devanshimaleri-hub/WRO2026_TeamAstra/other/20260812_190928.jpg

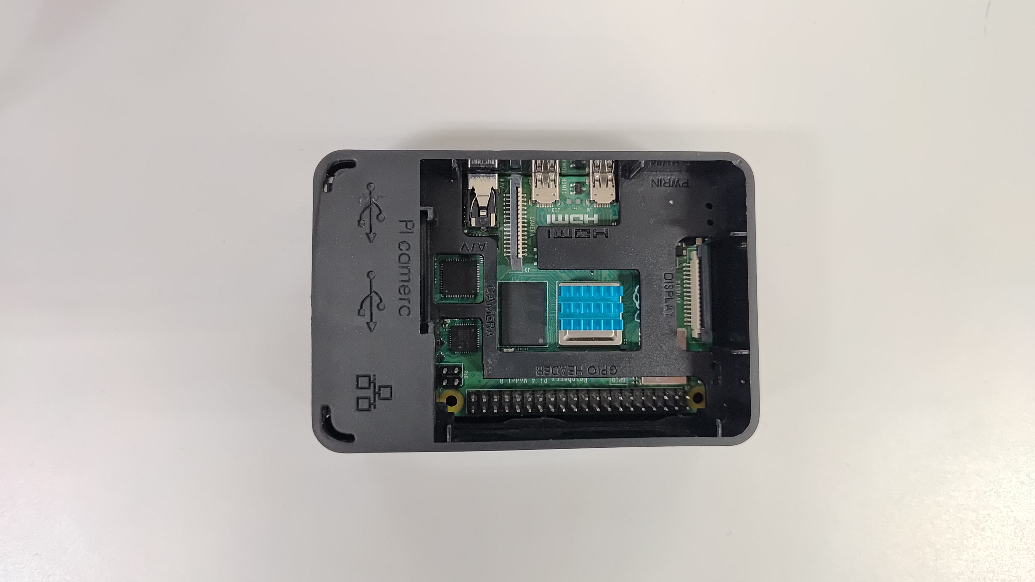
other/20260812_190928.jpg
