devanshimaleri-hub/WRO2026_TeamAstra/other/ackermann-diag.png

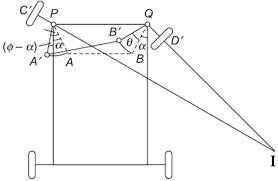
other/ackermann-diag.png
