devanshimaleri-hub/WRO2026_TeamAstra/other/ackermann-steering-linkage.jpg

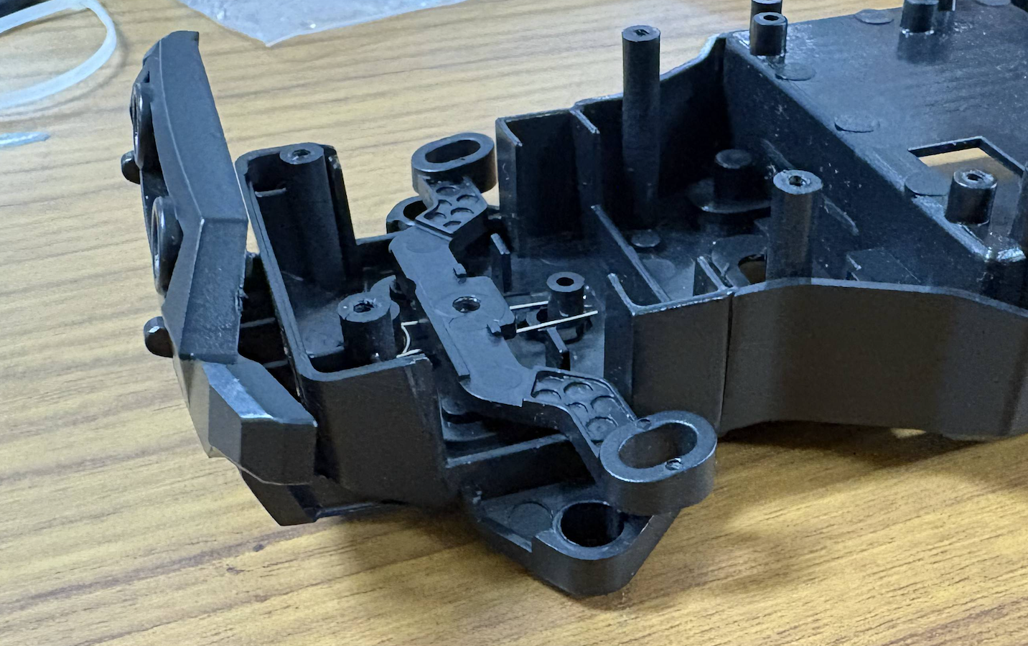
other/ackermann-steering-linkage.jpg
