devanshimaleri-hub/WRO2026_TeamAstra/other/AI cam connections.jpeg

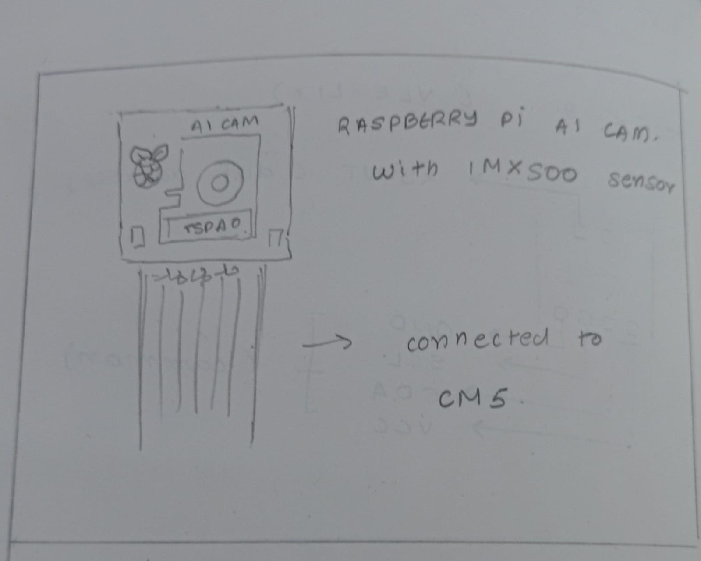
other/AI cam connections.jpeg
