devanshimaleri-hub/WRO2026_TeamAstra/other/baseplate-layout.jpg

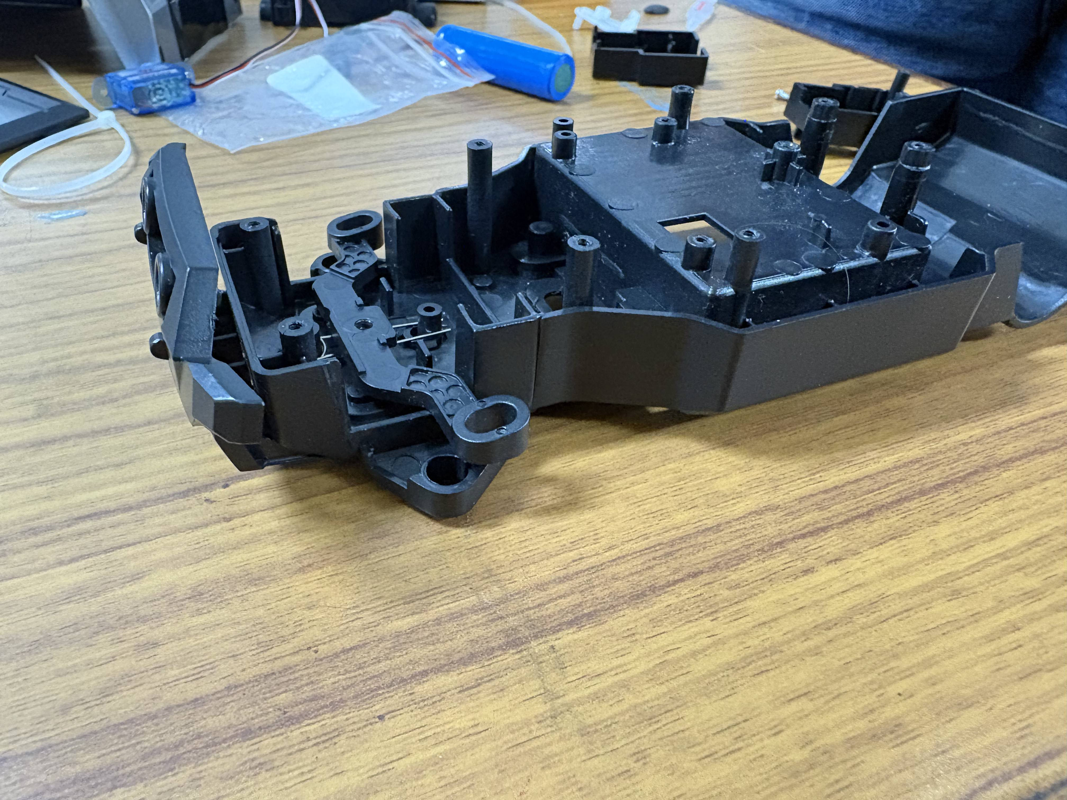
other/baseplate-layout.jpg
