devanshimaleri-hub/WRO2026_TeamAstra/other/Camera connector.jpeg

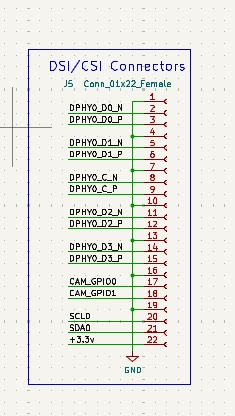
other/Camera connector.jpeg
