devanshimaleri-hub/WRO2026_TeamAstra/other/camera.jpg

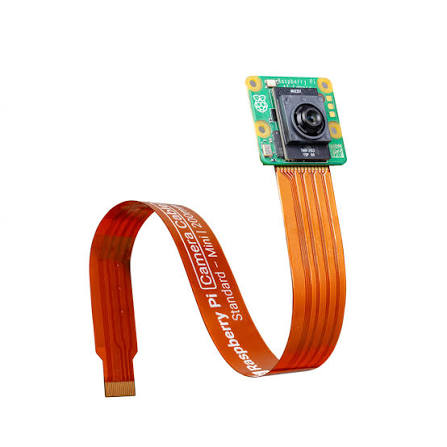
other/camera.jpg
