devanshimaleri-hub/WRO2026_TeamAstra/other/chassis-overview-2.jpg

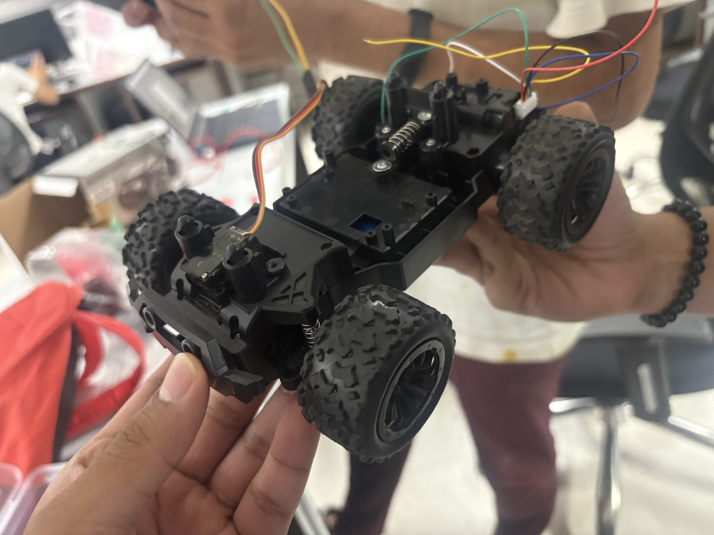
other/chassis-overview-2.jpg
