devanshimaleri-hub/WRO2026_TeamAstra/other/chassis-overview.jpg

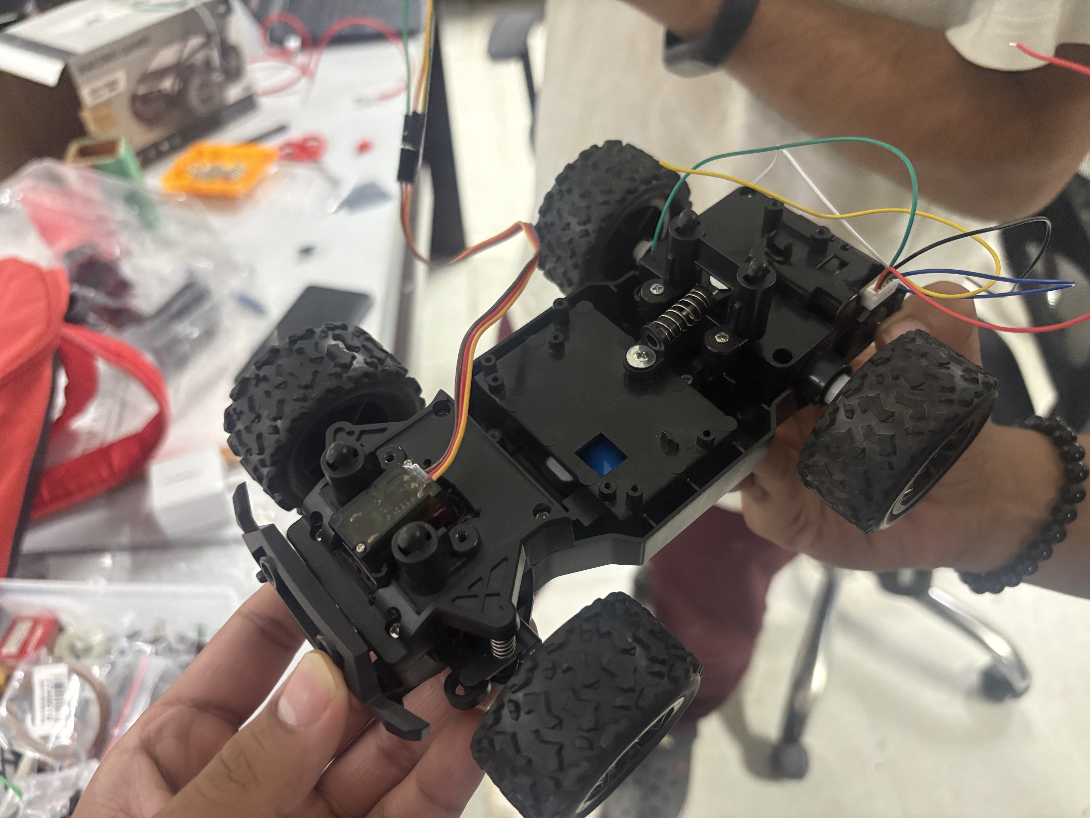
other/chassis-overview.jpg
