devanshimaleri-hub/WRO2026_TeamAstra/other/CM5 connector 1.jpeg

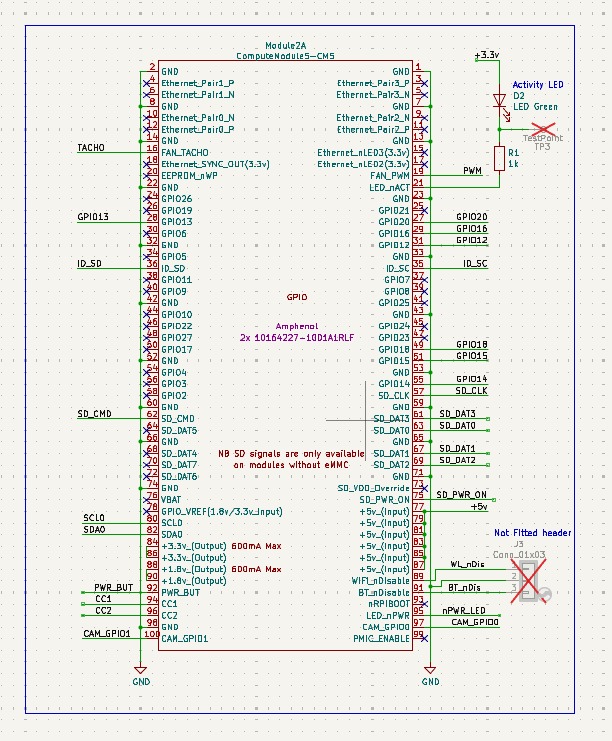
other/CM5 connector 1.jpeg
