devanshimaleri-hub/WRO2026_TeamAstra/other/Current limit switch.jpeg

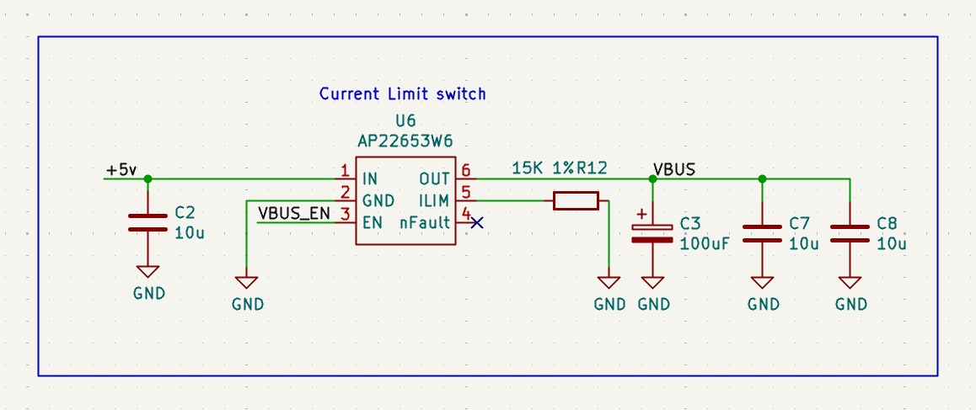
other/Current limit switch.jpeg
