devanshimaleri-hub/WRO2026_TeamAstra/other/differential-drive.jpeg

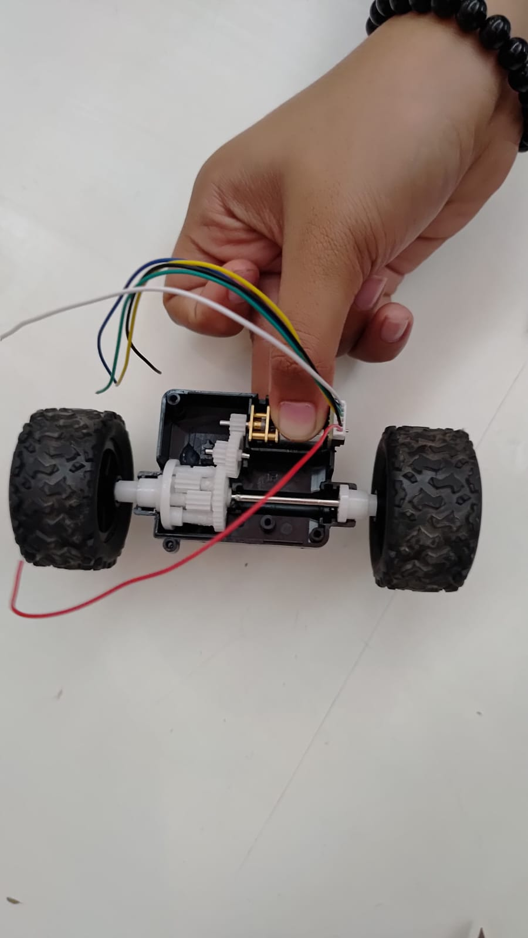
other/differential-drive.jpeg
