devanshimaleri-hub/WRO2026_TeamAstra/other/DRV8833.jpeg

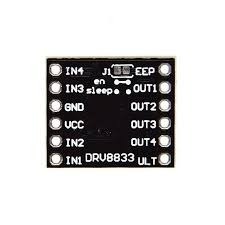
other/DRV8833.jpeg
