devanshimaleri-hub/WRO2026_TeamAstra/other/Fan connector.jpeg

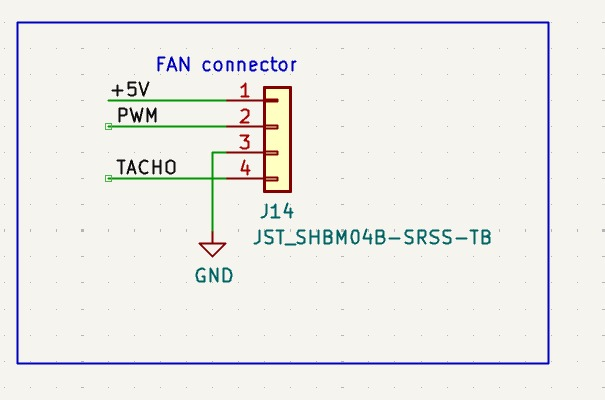
other/Fan connector.jpeg
