devanshimaleri-hub/WRO2026_TeamAstra/other/IMU connections.jpeg

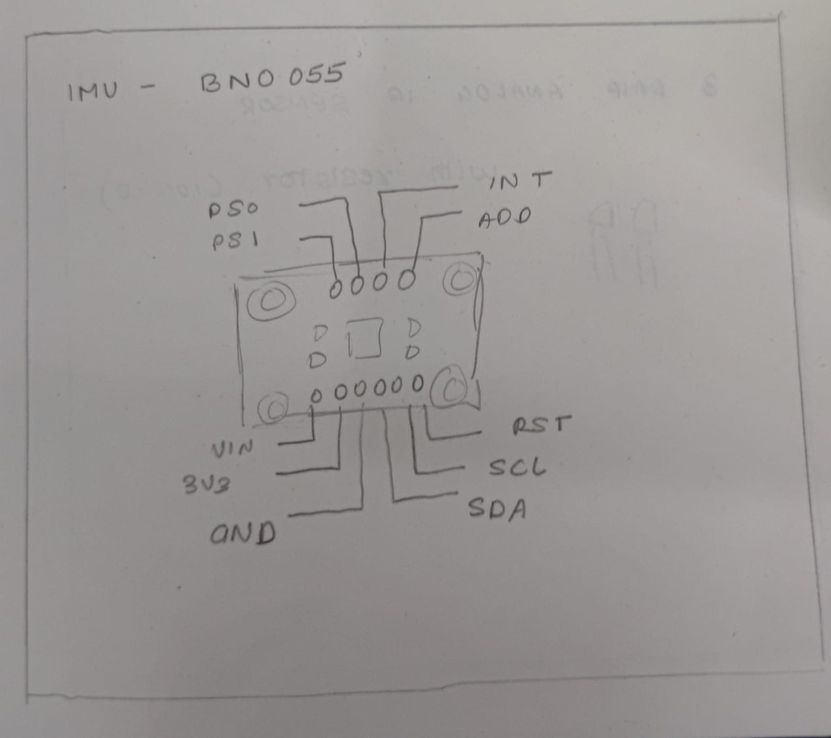
other/IMU connections.jpeg
