devanshimaleri-hub/WRO2026_TeamAstra/other/ir.png

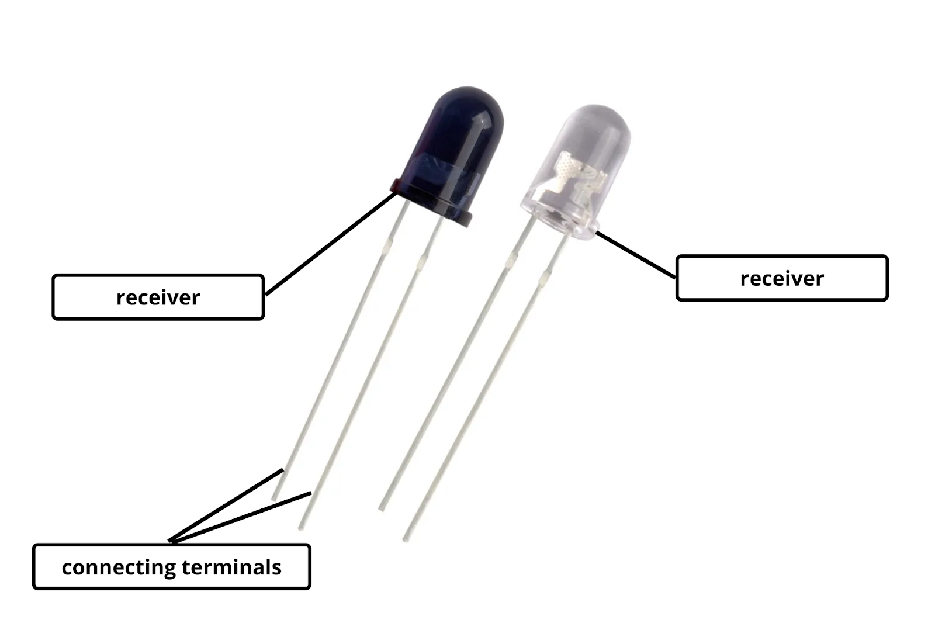
other/ir.png
