devanshimaleri-hub/WRO2026_TeamAstra/other/iteration-1.jpg

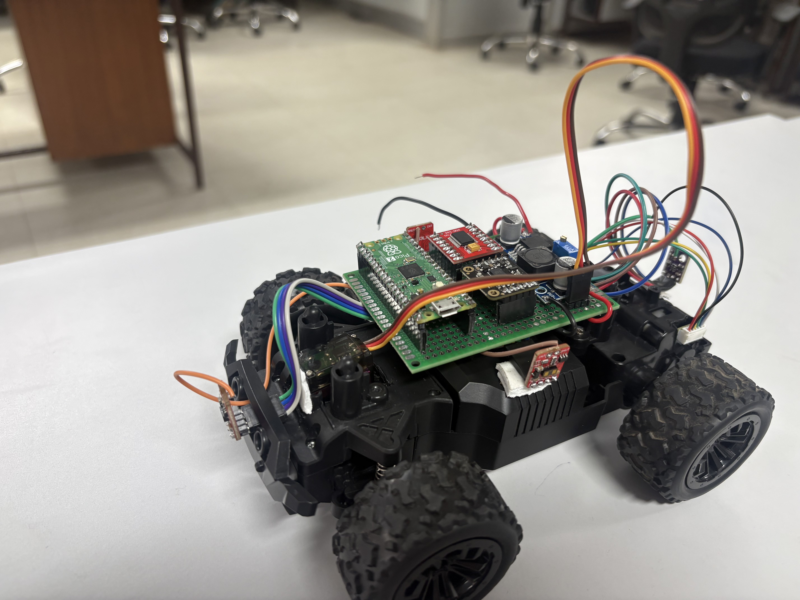
other/iteration-1.jpg
