devanshimaleri-hub/WRO2026_TeamAstra/other/Micro Servo.jpeg

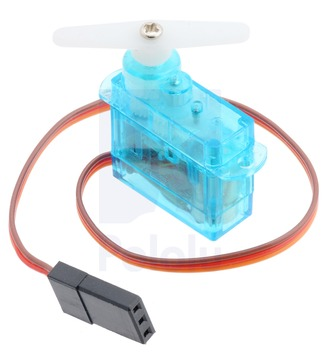
other/Micro Servo.jpeg
