devanshimaleri-hub/WRO2026_TeamAstra/other/SD card.jpeg

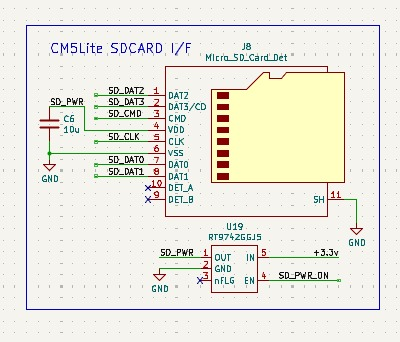
other/SD card.jpeg
