devanshimaleri-hub/WRO2026_TeamAstra/other/servo-mount-for-steering.jpg

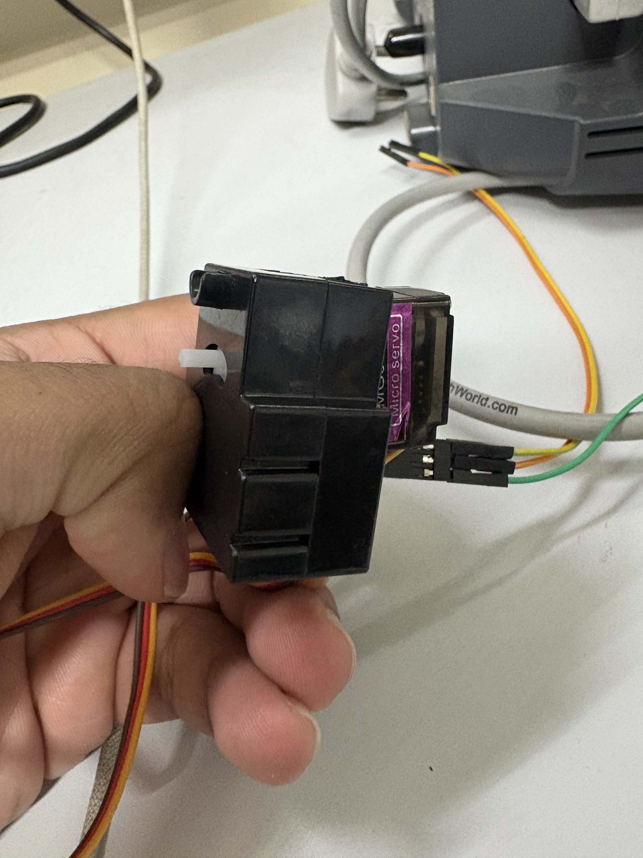
other/servo-mount-for-steering.jpg
