devanshimaleri-hub/WRO2026_TeamAstra/other/Tof connections.jpeg

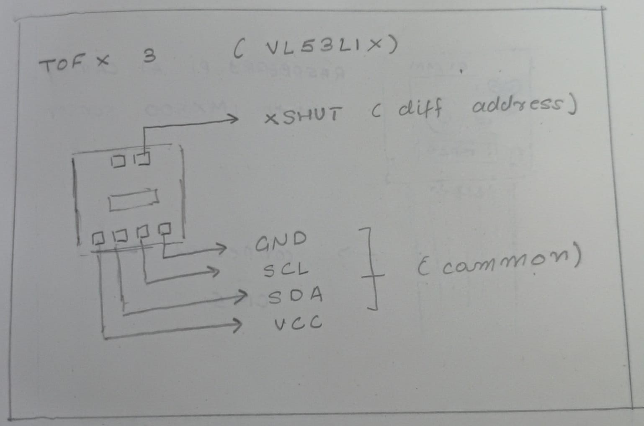
other/Tof connections.jpeg
