devanshimaleri-hub/WRO2026_TeamAstra/other/USB A connector.jpeg

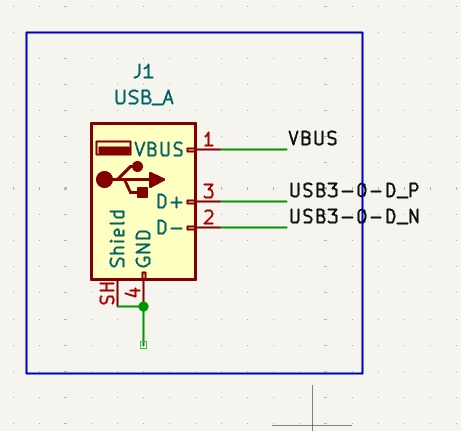
other/USB A connector.jpeg
