devanshimaleri-hub/WRO2026_TeamAstra/other/USB C connector.jpeg

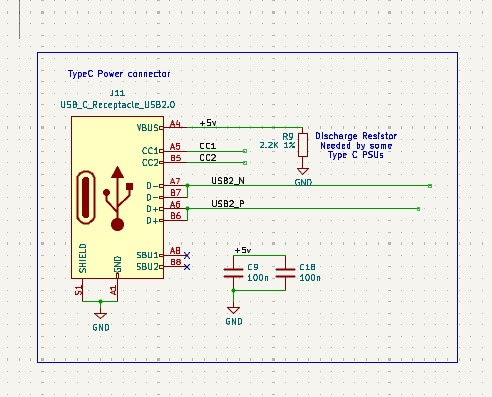
other/USB C connector.jpeg
