devanshimaleri-hub/WRO2026_TeamAstra/other/vl53l1x.jpg

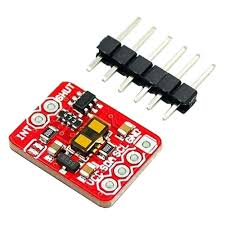
other/vl53l1x.jpg
