devanshimaleri-hub/WRO2026_TeamAstra/other/wheel-config.jpg

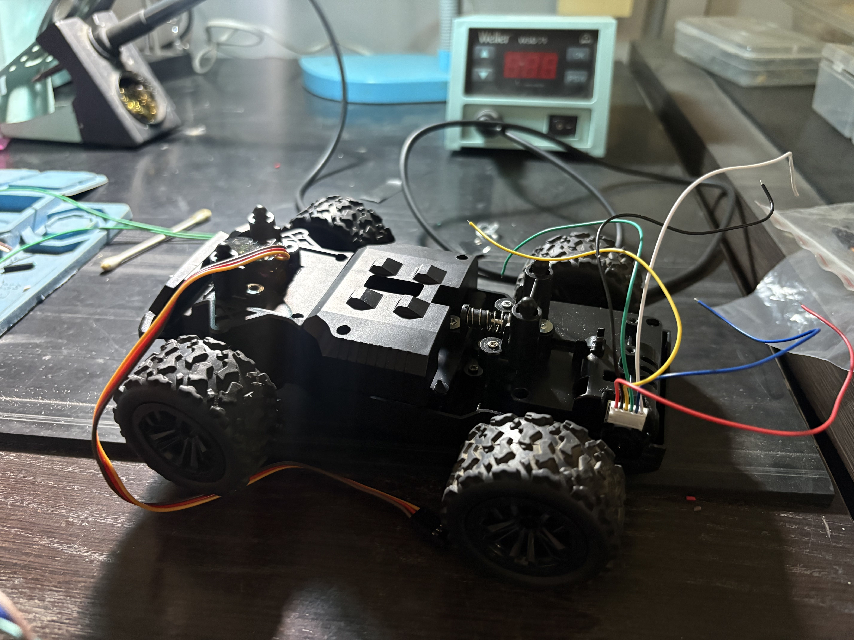
other/wheel-config.jpg
