devanshimaleri-hub/WRO2026_TeamAstra/other/all_wiring.jpg

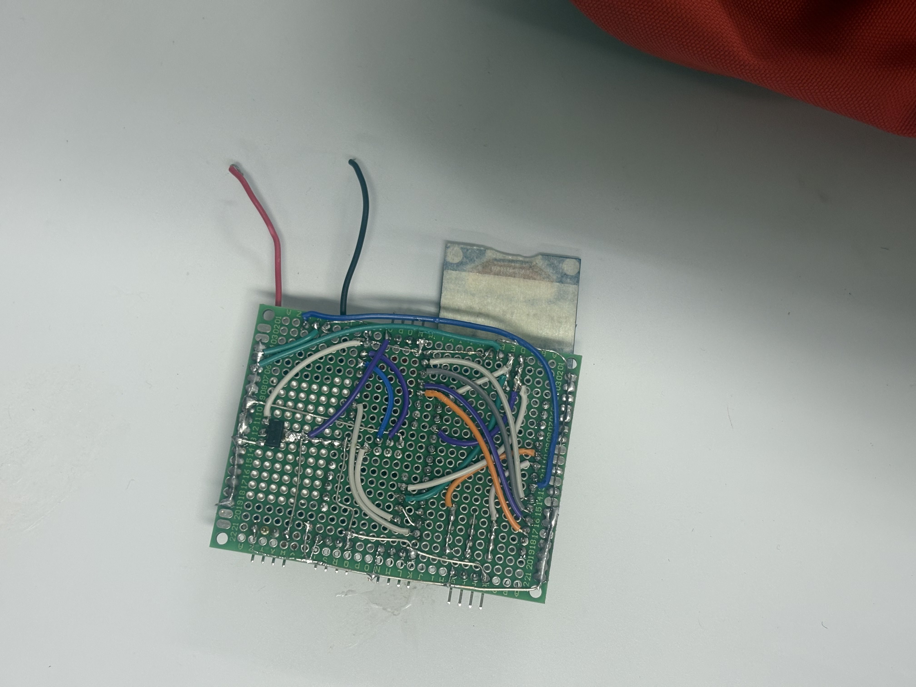
other/all_wiring.jpg
