devanshimaleri-hub/WRO2026_TeamAstra/(commit log)

2026-08-05 Images of Pcb, circuit and Mechanical structure.
2026-08-08 added challenge overview, power consumption breakdown, images
